RaduPotlog/rover_bms_ble_controller_hw/rover_led_udp_controller_hw/rover_led_udp_controller_hw.kicad_pcb

## KiCad design rover_led_udp_controller_hw/rover_led_udp_controller_hw.kicad_pcb (2026-07-26)

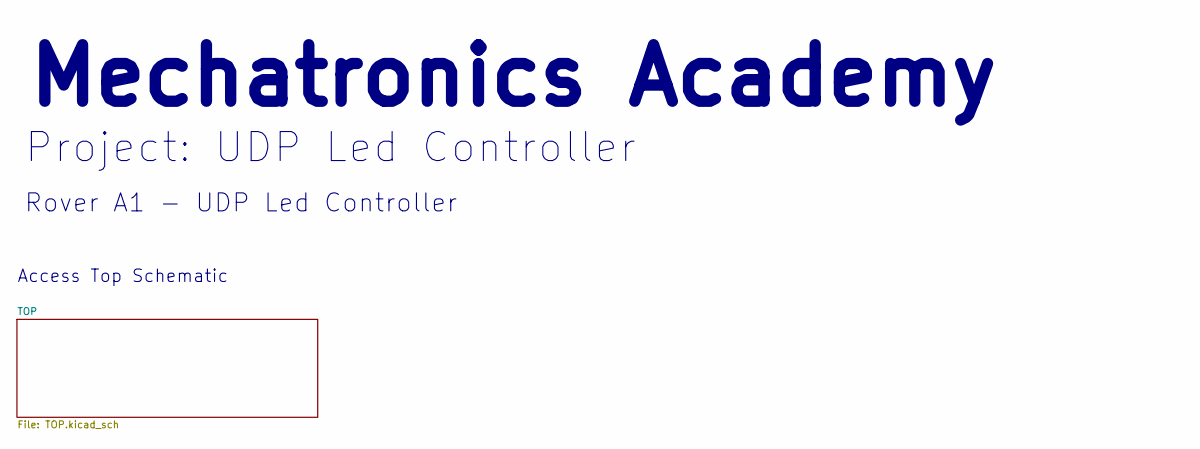
[picture p1: schematic rover_led_udp_controller_hw.kicad_sch, Home]

Notes on the sheet:
Rover A1 - UDP Led Controller
Project: UDP Led Controller
Access Top Schematic
Mechatronics Academy

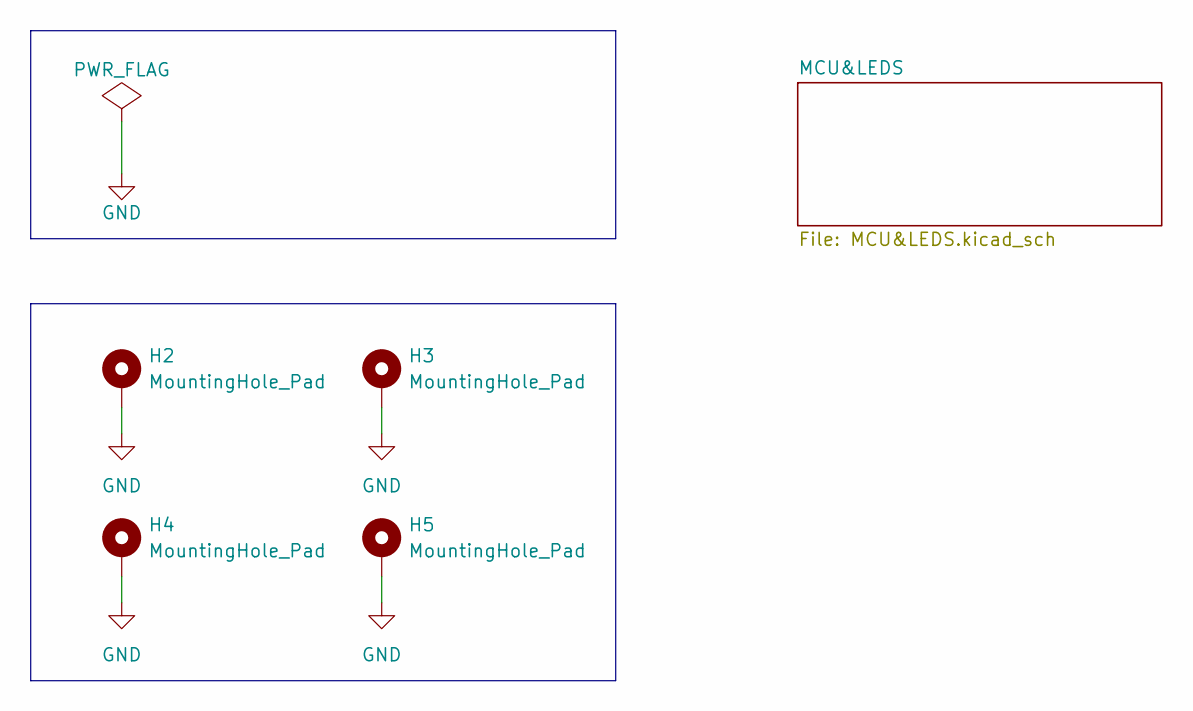
[picture p2: schematic TOP.kicad_sch]

Parts:
H2, H3, H4, H5: MountingHole_Pad; MountingHole_2.5mm_Pad_Via

Connections:
GND: H2.1 (1_1), H3.1 (1_1), H4.1 (1_1), H5.1 (1_1); also elsewhere on the board

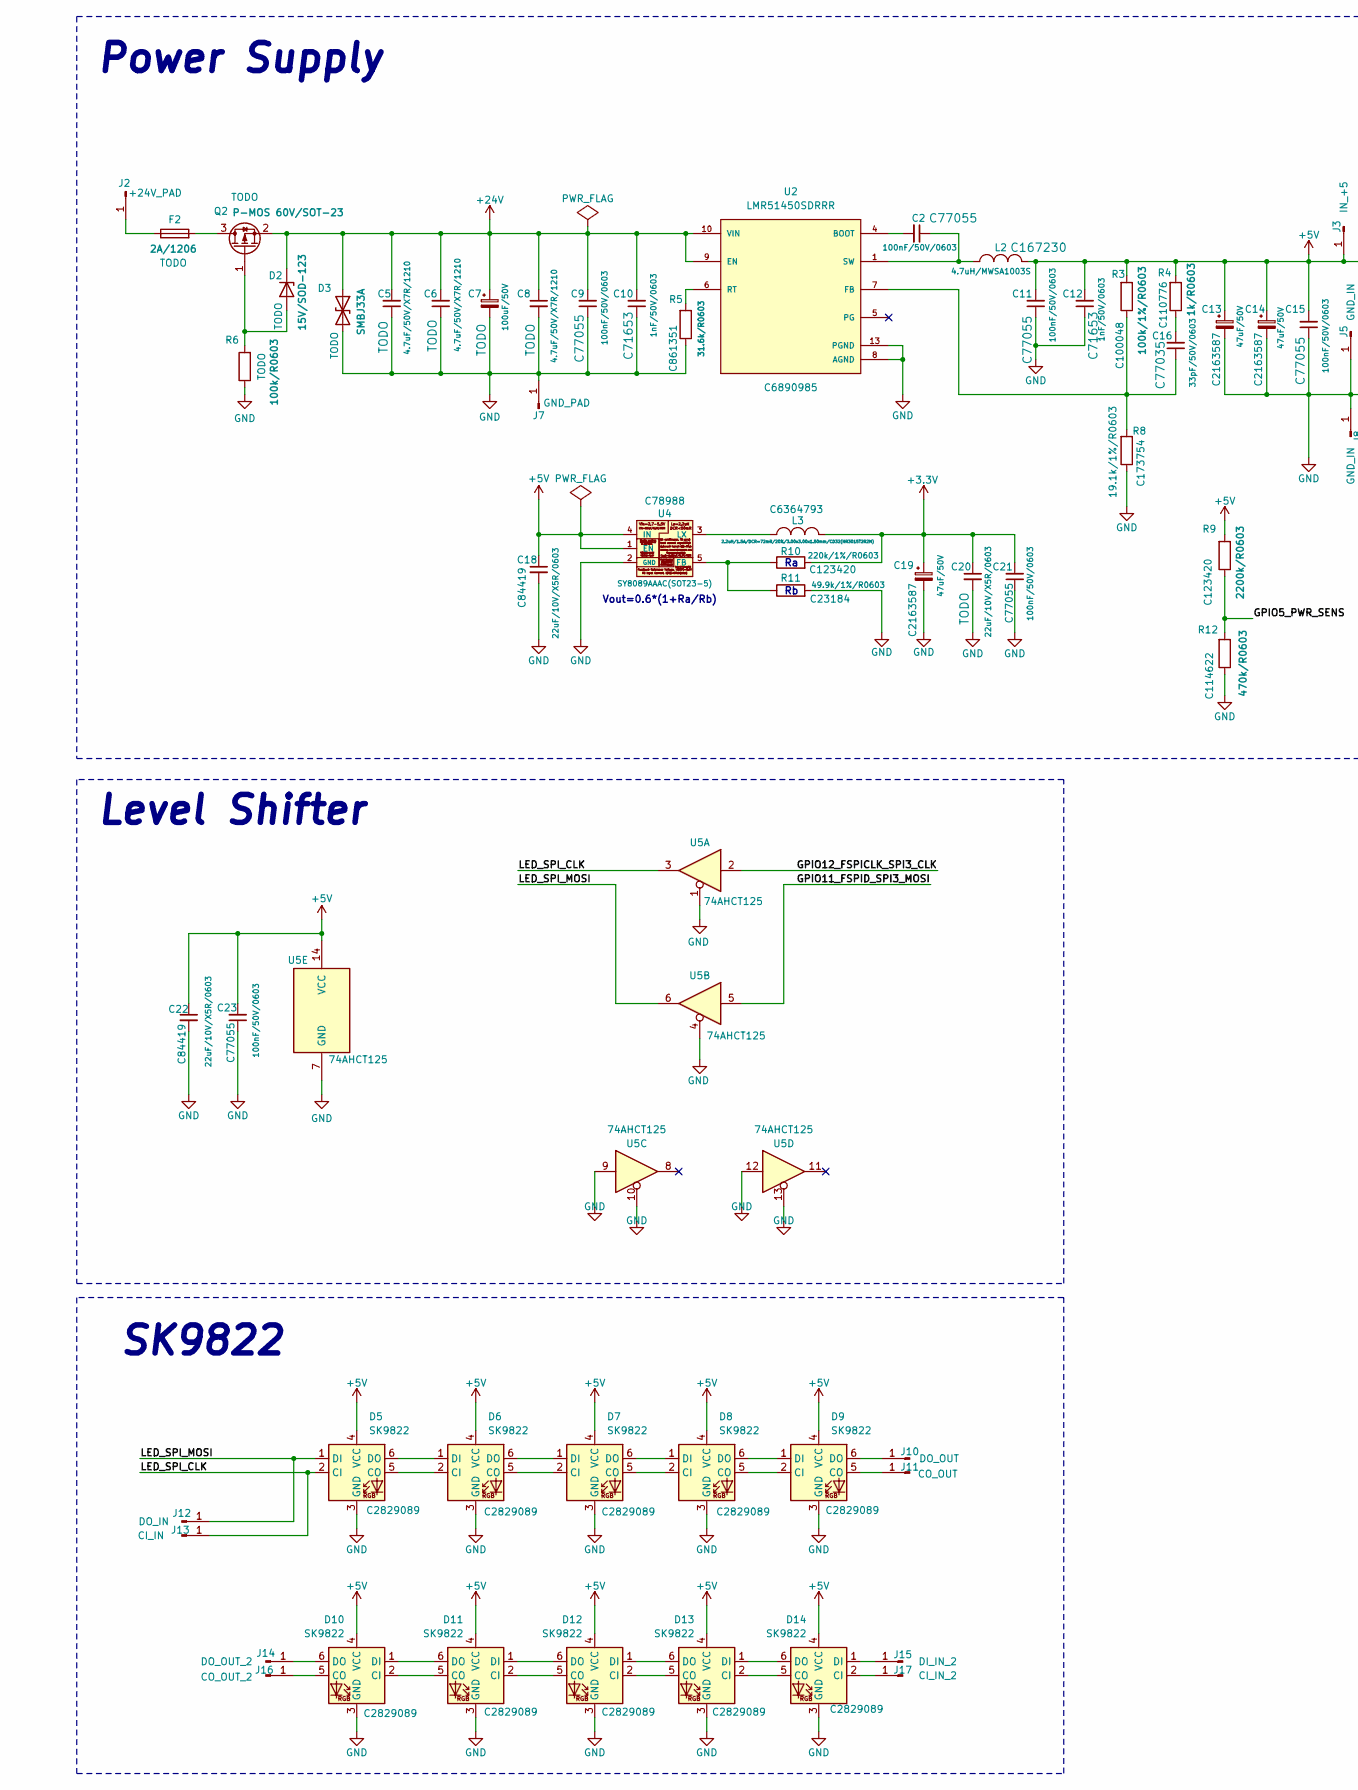
[picture p3: schematic MCU&LEDS.kicad_sch, part in row 1, column 1]

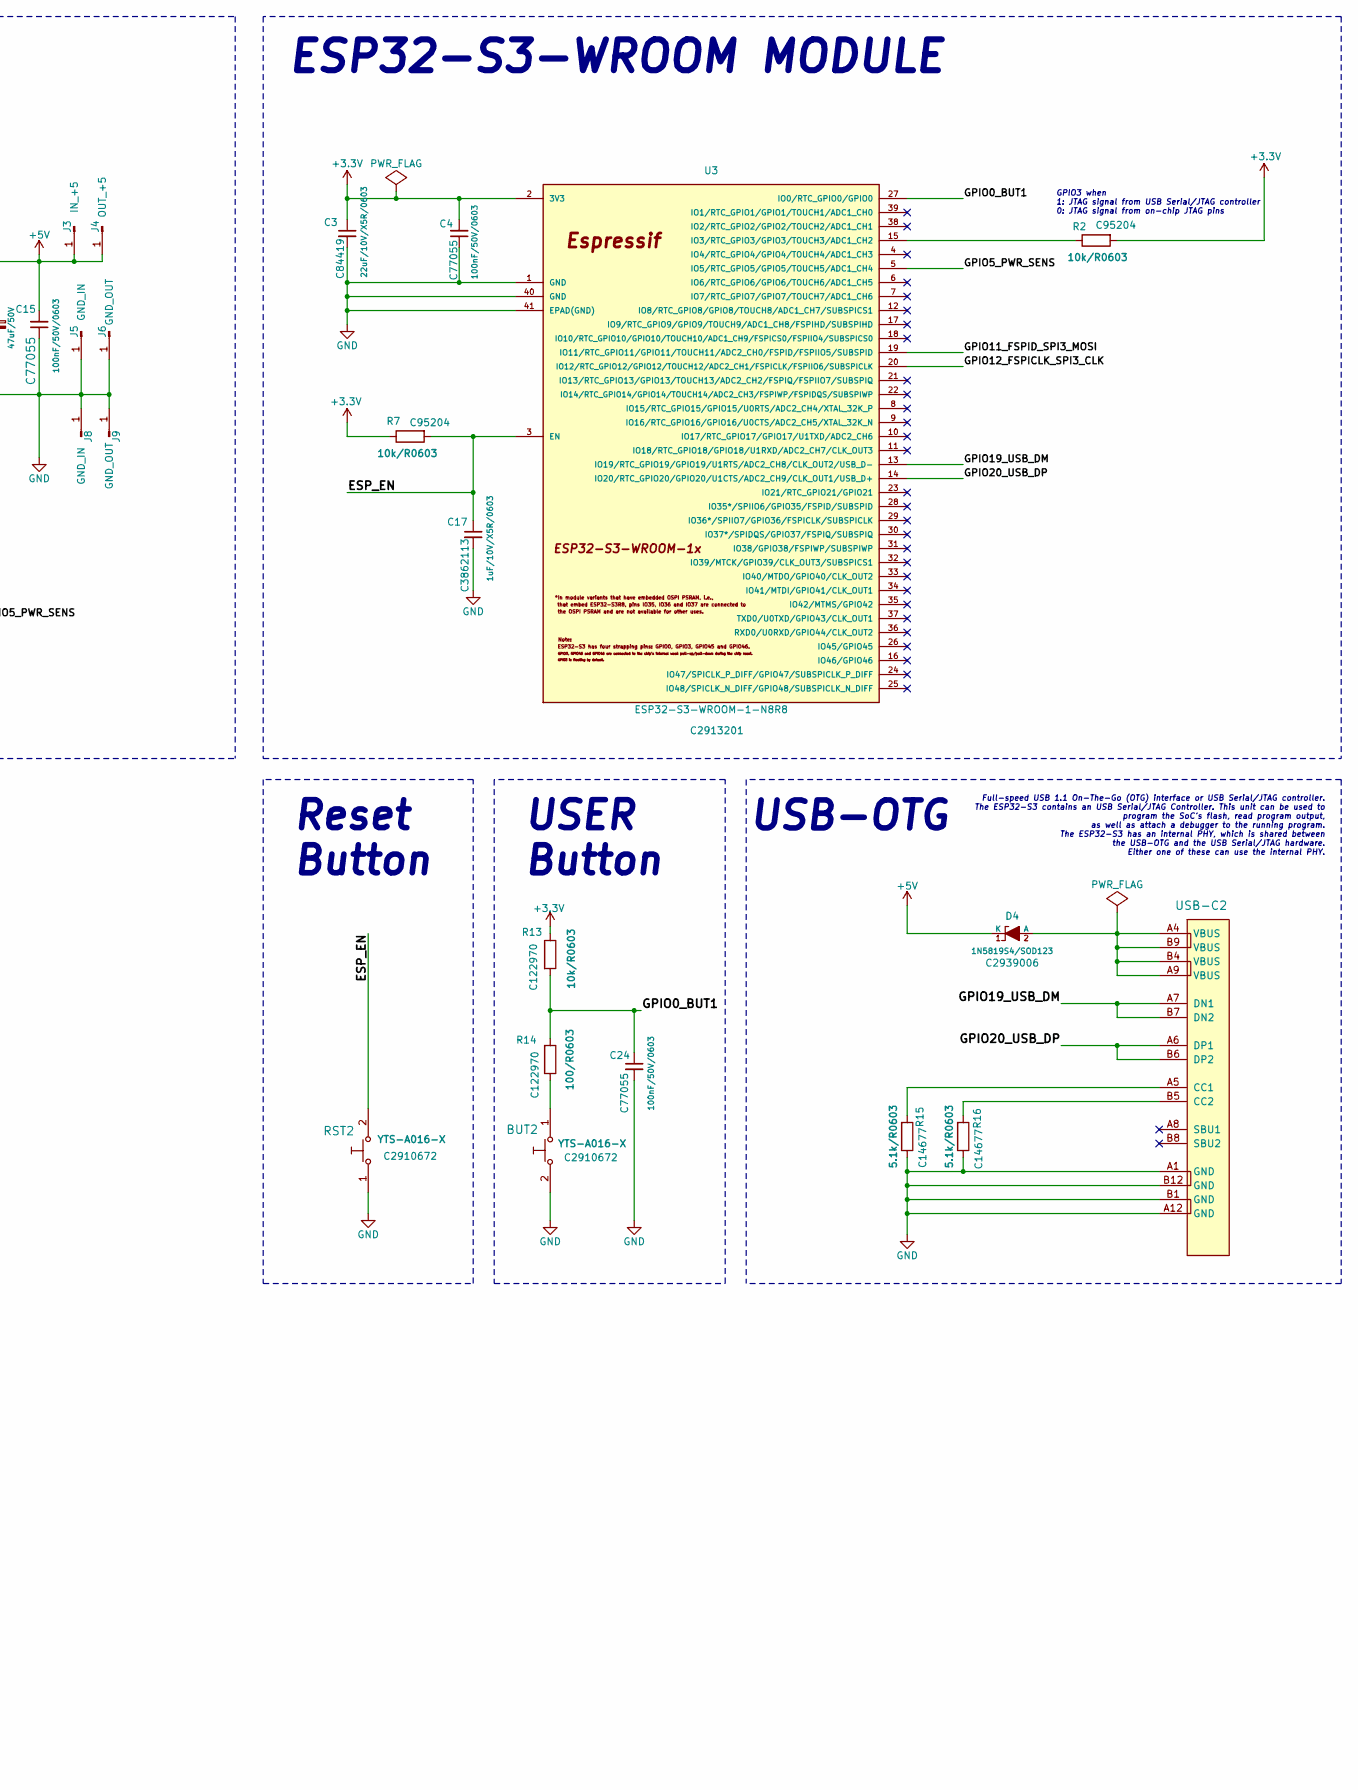
[picture p4: schematic MCU&LEDS.kicad_sch, part in row 1, column 2]

Parts:
BUT2: YTS-A016-X; JLCPCB C2910672
C2, C4, C9, C11, C15, C21, C23, C24: 100nF/50V/0603; C_0603_1608Metric; JLCPCB C77055
C3, C18, C22: 22uF/10V/X5R/0603; C_0603_1608Metric; JLCPCB C84419
C5, C6, C8: 4.7uF/50V/X7R/1210; C_1210_3225Metric; JLCPCB TODO
C7: 100uF/50V; CP_Elec_8x10.5; JLCPCB TODO
C10, C12: 1nF/50V/0603; C_0603_1608Metric; JLCPCB C71653
C13, C14, C19: 47uF/50V; CP_Elec_6.3x7.7; JLCPCB C2163587
C16: 33pF/50V/0603; C_0603_1608Metric; JLCPCB C77035
C17: 1uF/10V/X5R/0603; C_0603_1608Metric; JLCPCB C3862113
C20: 22uF/10V/X5R/0603; C_0603_1608Metric; JLCPCB TODO
D2: 15V/SOD-123; D_SOD-123; JLCPCB TODO
D3: SMBJ33A; D_SMB; JLCPCB TODO
D4: 1N5819S4/SOD123; SOD-123_1C-2A_KA; JLCPCB C2939006
D5, D6, D7, D8, D9, D10, D11, D12, D13, D14: SK9822; LED_RGB_5050-6; JLCPCB C2829089
F2: 2A/1206; Fuse_1206_3216Metric; JLCPCB TODO
J2: +24V_PAD; TestPoint_Pad_1
J3: IN_+5; TestPoint_Pad_1
J4: OUT_+5; TestPoint_Pad_1
J5, J8: GND_IN; TestPoint_Pad_1
J6, J9: GND_OUT; TestPoint_Pad_1
J7: GND_PAD; TestPoint_Pad_1
J10: DO_OUT; TestPoint_Pad
J11: CO_OUT; TestPoint_Pad
J12: DO_IN; TestPoint_Pad
J13: CI_IN; TestPoint_Pad
J14: DO_OUT_2; TestPoint_Pad
J15: DI_IN_2; TestPoint_Pad
J16: CO_OUT_2; TestPoint_Pad
J17: CI_IN_2; TestPoint_Pad
L2: 4.7uH/MWSA1003S; L_Sunlord_MWSA1003S; JLCPCB C167230
L3: 2.2uH/1.5A/DCR=72mR/20%/3.00x3.00x1.50mm/CD32(NR3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; CD32; JLCPCB C6364793
Q2: P-MOS 60V/SOT-23; SOT-23; JLCPCB TODO
R2, R7: 10k/R0603; R_0603_1608Metric_Pad0.98x0.95mm_HandSolder; JLCPCB C95204
R3: 100k/1%/R0603; R_0603_1608Metric_Pad0.98x0.95mm_HandSolder; JLCPCB C100048
R4: 1k/R0603; R_0603_1608Metric_Pad0.98x0.95mm_HandSolder; JLCPCB C110776
R5: 31.6k/R0603; R_0603_1608Metric_Pad0.98x0.95mm_HandSolder; JLCPCB C861351
R6: 100k/R0603; R_0603_1608Metric_Pad0.98x0.95mm_HandSolder; JLCPCB TODO
R8: 19.1k/1%/R0603; R_0603_1608Metric_Pad0.98x0.95mm_HandSolder; JLCPCB C173754
R9: 2200k/R0603; R_0603_1608Metric_Pad0.98x0.95mm_HandSolder; JLCPCB C123420
R10: 220k/1%/R0603; R_0603_1608Metric_Pad0.98x0.95mm_HandSolder; JLCPCB C123420
R11: 49.9k/1%/R0603; R_0603_1608Metric_Pad0.98x0.95mm_HandSolder; JLCPCB C23184
R12: 470k/R0603; R_0603_1608Metric_Pad0.98x0.95mm_HandSolder; JLCPCB C114622
R13: 10k/R0603; R_0603_1608Metric_Pad0.98x0.95mm_HandSolder; JLCPCB C122970
R14: 100/R0603; R_0603_1608Metric_Pad0.98x0.95mm_HandSolder; JLCPCB C122970
R15, R16: 5.1k/R0603; R_0603_1608Metric_Pad0.98x0.95mm_HandSolder; JLCPCB C14677
RST2: YTS-A016-X; JLCPCB C2910672
U2: LMR51450SDRRR; PARTREV December 2022; JLCPCB C6890985
U3: ESP32-S3-WROOM-1-N8R8; ESP32-­S3-­WROOM­-1; JLCPCB C2913201
U4: SY8089AAAC(SOT23-5); SOT-23-5; JLCPCB C78988
U5: 74AHCT125; SOIC-14_3.9x8.7mm_P1.27mm
USB-C2: USB2.0_TYPE-C(A40-00119-A52-12); USB2.0_TYPE-C-ONLY-PADS

Connections:
+3.3V: C3.1, C4.2, C19.1, C20.1, C21.2, L3.2, R2.2, R7.1, R10.2, R13.1, U3.2 (3V3)
+5V: C11.2, C12.2, C13.1, C14.1, C15.2, C18.1, C22.1, C23.2, D4.1 (K), D5.4 (VCC), D6.4 (VCC), D7.4 (VCC), D8.4 (VCC), D9.4 (VCC), D10.4 (VCC), D11.4 (VCC), D12.4 (VCC), D13.4 (VCC), D14.4 (VCC), J3.1 (Pin_1_1), J4.1 (Pin_1_1), L2.2, R3.2, R4.2, R9.2, U4.1 (EN), U4.4 (IN), U5.14 (VCC)
+24V: C5.2, C6.2, C7.1, C8.1, C9.2, C10.2, D2.1 (K), D3.1 (A1), Q2.2 (S), U2.9 (EN), U2.10 (VIN), U2.11 (VIN), U2.12 (VIN)
/TOP/MCU&LEDS/ESP_EN: C17.1, R7.2, RST2.2, U3.3 (EN)
/TOP/MCU&LEDS/GPIO0_BUT1: C24.1, R13.2, R14.2, U3.27 (IO0/RTC_GPIO0/GPIO0)
/TOP/MCU&LEDS/GPIO5_PWR_SENS: R9.1, R12.2, U3.5 (IO5/RTC_GPIO5/GPIO5/TOUCH5/ADC1_CH4)
/TOP/MCU&LEDS/GPIO11_FSPID_SPI3_MOSI: U3.19 (IO11/RTC_GPIO11/GPIO11/TOUCH11/ADC2_CH0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), U5.5
/TOP/MCU&LEDS/GPIO12_FSPICLK_SPI3_CLK: U3.20 (IO12/RTC_GPIO12/GPIO12/TOUCH12/ADC2_CH1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), U5.2
/TOP/MCU&LEDS/GPIO19_USB_DM: U3.13 (IO19/RTC_GPIO19/GPIO19/U1RTS/ADC2_CH8/C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), USB-C2.A7 (DN1), USB-C2.B7 (DN2)
/TOP/MCU&LEDS/GPIO20_USB_DP: U3.14 (IO20/RTC_GPIO20/GPIO20/U1CTS/ADC2_CH9/C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), USB-C2.A6 (DP1), USB-C2.B6 (DP2)
/TOP/MCU&LEDS/LED_SPI_CLK: D5.2 (CI), J13.1 (Pin_1_1), U5.3
/TOP/MCU&LEDS/LED_SPI_MOSI: D5.1 (DI), J12.1 (Pin_1_1), U5.6
GND: BUT2.2, C3.2, C4.1, C5.1, C6.1, C7.2, C8.2, C9.1, C10.1, C11.1, C12.1, C13.2, C14.2, C15.1, C17.2, C18.2, C19.2, C20.2, C21.1, C22.2, C23.1, C24.2, D3.2 (A2), D5.3 (GND), D6.3 (GND), D7.3 (GND), D8.3 (GND), D9.3 (GND), D10.3 (GND), D11.3 (GND), D12.3 (GND), D13.3 (GND), D14.3 (GND), J5.1 (Pin_1_1), J6.1 (Pin_1_1), J7.1 (Pin_1_1), J8.1 (Pin_1_1), J9.1 (Pin_1_1), R5.1, R6.1, R8.1, R11.2, R12.1, R15.1, R16.1, RST2.1, U2.8 (AGND), U2.13 (PGND), U3.1 (GND), U3.40 (GND), U3.41 (EPAD(GND)), U4.2 (GND), U5.1, U5.4, U5.7 (GND), U5.9, U5.10, U5.12, U5.13, USB-C2.A1 (GND), USB-C2.A12 (GND), USB-C2.B1 (GND), USB-C2.B12 (GND); also elsewhere on the board
unnamed: BUT2.1, R14.1
unnamed: C2.1, L2.1, U2.1 (SW), U2.2 (SW), U2.3 (SW)
unnamed: C16.2, R4.1
unnamed: D2.2 (A), Q2.1 (G), R6.2
unnamed: D4.2 (A), USB-C2.A4 (VBUS), USB-C2.A9 (VBUS), USB-C2.B4 (VBUS), USB-C2.B9 (VBUS)
unnamed: D5.5 (CO), D6.2 (CI)
unnamed: D5.6 (DO), D6.1 (DI)
unnamed: D6.5 (CO), D7.2 (CI)
unnamed: D6.6 (DO), D7.1 (DI)
unnamed: D7.5 (CO), D8.2 (CI)
unnamed: D7.6 (DO), D8.1 (DI)
unnamed: D8.5 (CO), D9.2 (CI)
unnamed: D8.6 (DO), D9.1 (DI)
unnamed: D9.5 (CO), J11.1 (Pin_1_1)
unnamed: D9.6 (DO), J10.1 (Pin_1_1)
unnamed: D10.2 (CI), D11.5 (CO)
unnamed: D10.5 (CO), J16.1 (Pin_1_1)
unnamed: D10.1 (DI), D11.6 (DO)
unnamed: D10.6 (DO), J14.1 (Pin_1_1)
unnamed: D11.2 (CI), D12.5 (CO)
unnamed: D11.1 (DI), D12.6 (DO)
unnamed: D12.2 (CI), D13.5 (CO)
unnamed: D12.1 (DI), D13.6 (DO)
unnamed: D13.2 (CI), D14.5 (CO)
unnamed: D13.1 (DI), D14.6 (DO)
unnamed: D14.2 (CI), J17.1 (Pin_1_1)
unnamed: D14.1 (DI), J15.1 (Pin_1_1)
unnamed: F2.1, J2.1 (Pin_1_1)
unnamed: F2.2, Q2.3 (D)
unnamed: C2.2, U2.4 (BOOT)
unnamed: C16.1, R3.1, R8.2, U2.7 (FB)
unnamed: R5.2, U2.6 (RT)
unnamed: R2.1, U3.15 (IO3/RTC_GPIO3/GPIO3/TOUCH3/ADC1_CH2)
unnamed: R10.1, R11.1, U4.5 (FB)
unnamed: L3.1, U4.3 (LX)
unnamed: R15.2, USB-C2.A5 (CC1)
unnamed: R16.2, USB-C2.B5 (CC2)

Notes on the sheet:
ESP32-S3-WROOM MODULE
Power Supply
Full-speed USB 1.1 On-The-Go (OTG) interface or USB Serial/JTAG controller. The ESP32-S3 contains an USB Serial/JTAG Controller. This unit can be used to program the SoC’s flash, read program output, as well as attach a debugger to the running program. The ESP32-S3 has an internal PHY, which is sha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
Vout=0.6*(1+Ra/Rb)
GPIO3 when 1: JTAG signal from USB Serial/JTAG controller 0: JTAG signal from on-chip JTAG pins
Reset Button
USB-OTG
Level Shifter
SK9822
USER Button

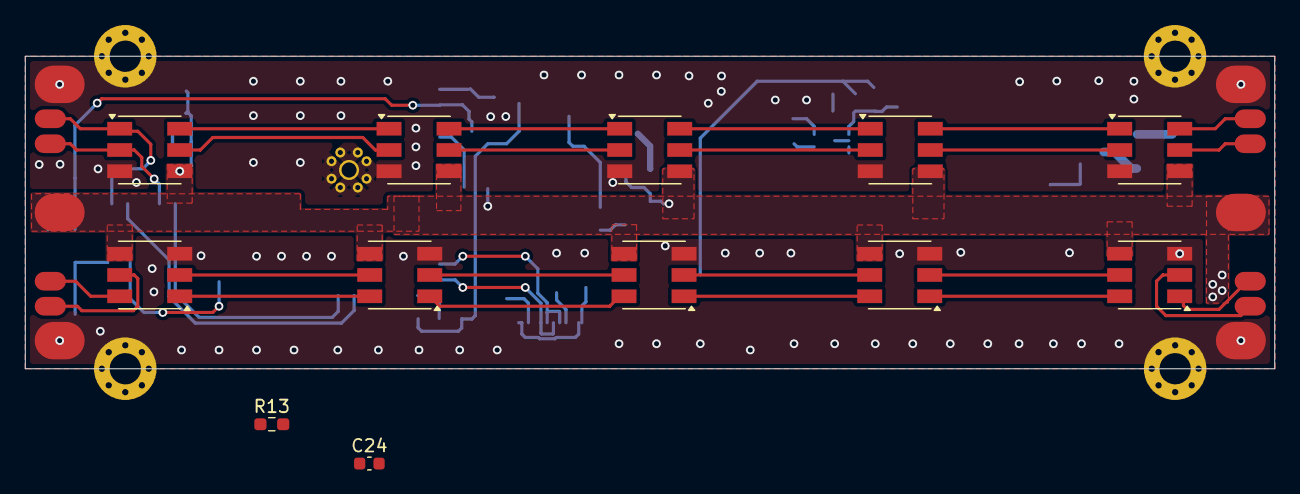
[picture p5: board rover_led_udp_controller_hw.kicad_pcb from above]

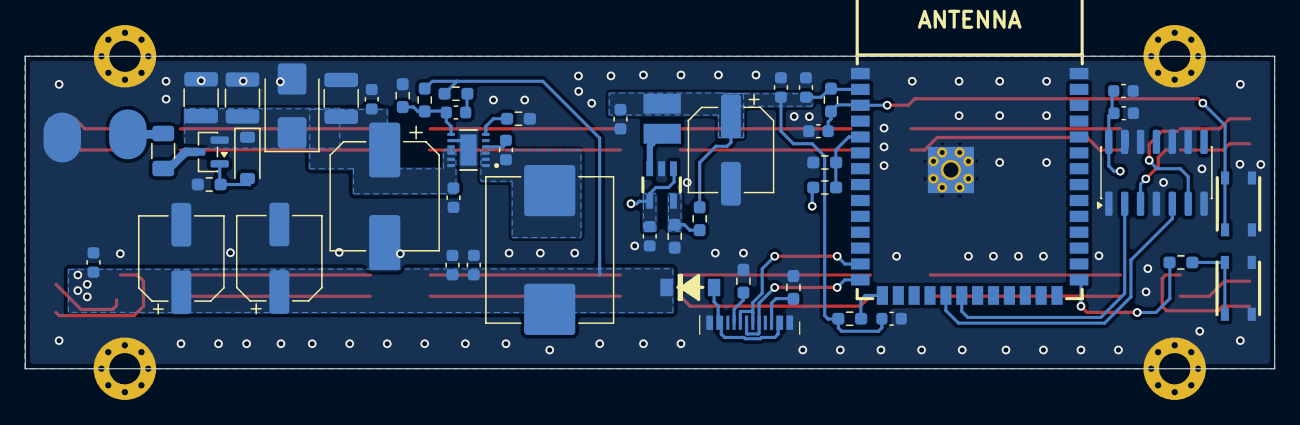
[picture p6: board rover_led_udp_controller_hw.kicad_pcb from below]

Board: 2 copper layers, 100.0 x 25.0 mm, 82 parts (52 on the bottom side), 50 nets.
