RaduPotlog/rover_bms_ble_controller_hw/(commit log)

2026-07-26 Polarity protection and TSV protection
    [MCU&LEDS.kicad_sch]
2026-07-26 Fix F-01, F-02
    [MCU&LEDS.kicad_sch]
2026-07-26 PCB redesign
    [MCU&LEDS.kicad_sch, rover_led_udp_controller_hw.kicad_pcb]
